collinpowerkariman/ECU/hardware/CAM/CAM.csv

Source: | /home/collyn/KiCAD/CAM_Module/CAM_Module.kicad_sch
Date: | Min 06 Agu 2023 08:49:48
Tool: | Eeschema 7.0.6-7.0.6~ubuntu22.04.1
Generator: | /usr/share/kicad/plugins/bom_csv_grouped_by_value.py
Component Count: | 14
Collated Components:
Item | Qty | Reference(s) | Value | LibPart | Footprint | Datasheet | DNP
1 | 2 | C1, C3 | 100nf | Device:C | Capacitor_SMD:C_0603_1608Metric_Pad1.08x0.95mm_HandSolder | ~
2 | 1 | C2 | 1uf | Device:C | Capacitor_SMD:C_0603_1608Metric_Pad1.08x0.95mm_HandSolder | ~
3 | 1 | C4 | 0.33uf | Device:C | Capacitor_SMD:C_0603_1608Metric_Pad1.08x0.95mm_HandSolder | ~
4 | 2 | D1, D2 | LED | Device:LED | LED_SMD:LED_0603_1608Metric_Pad1.05x0.95mm_HandSolder | ~
5 | 1 | D3 | 5.5v | Device:D_Zener | Diode_SMD:D_0603_1608Metric_Pad1.05x0.95mm_HandSolder | ~
6 | 1 | J1 | Connector | Connector:Conn_01x06_Pin | Connector_PinHeader_2.54mm:PinHeader_1x06_P2.54mm_Vertical | ~
7 | 1 | JP1 | ~ | Jumper:SolderJumper_2_Open | Jumper:SolderJumper-2_P1.3mm_Open_RoundedPad1.0x1.5mm | ~
8 | 1 | JP2 | 5V/12V | Jumper:Jumper_3_Open | Connector_PinHeader_2.54mm:PinHeader_1x03_P2.54mm_Vertical | ~
9 | 1 | R1 | 220 | Device:R | Resistor_SMD:R_0603_1608Metric_Pad0.98x0.95mm_HandSolder | ~
10 | 1 | R2 | 680 | Device:R | Resistor_SMD:R_0603_1608Metric_Pad0.98x0.95mm_HandSolder | ~
11 | 1 | U1 | AS5047P | Sensor_Magnetic:AS5047D | Package_SO:TSSOP-14_4.4x5mm_P0.65mm | https://ams.com/documents/20143/36005/AS5047D_DS000394_2-00.pdf
12 | 1 | U2 | LM78M05_TO252 | Regulator_Linear:LM78M05_TO252 | Package_TO_SOT_SMD:TO-252-2 | https://www.onsemi.com/pub/Collateral/MC78M00-D.PDF
