collinpowerkariman/ECU/hardware/ECU/ECU.kicad_pcb

## KiCad design hardware/ECU/ECU.kicad_pcb (2023-11-11)

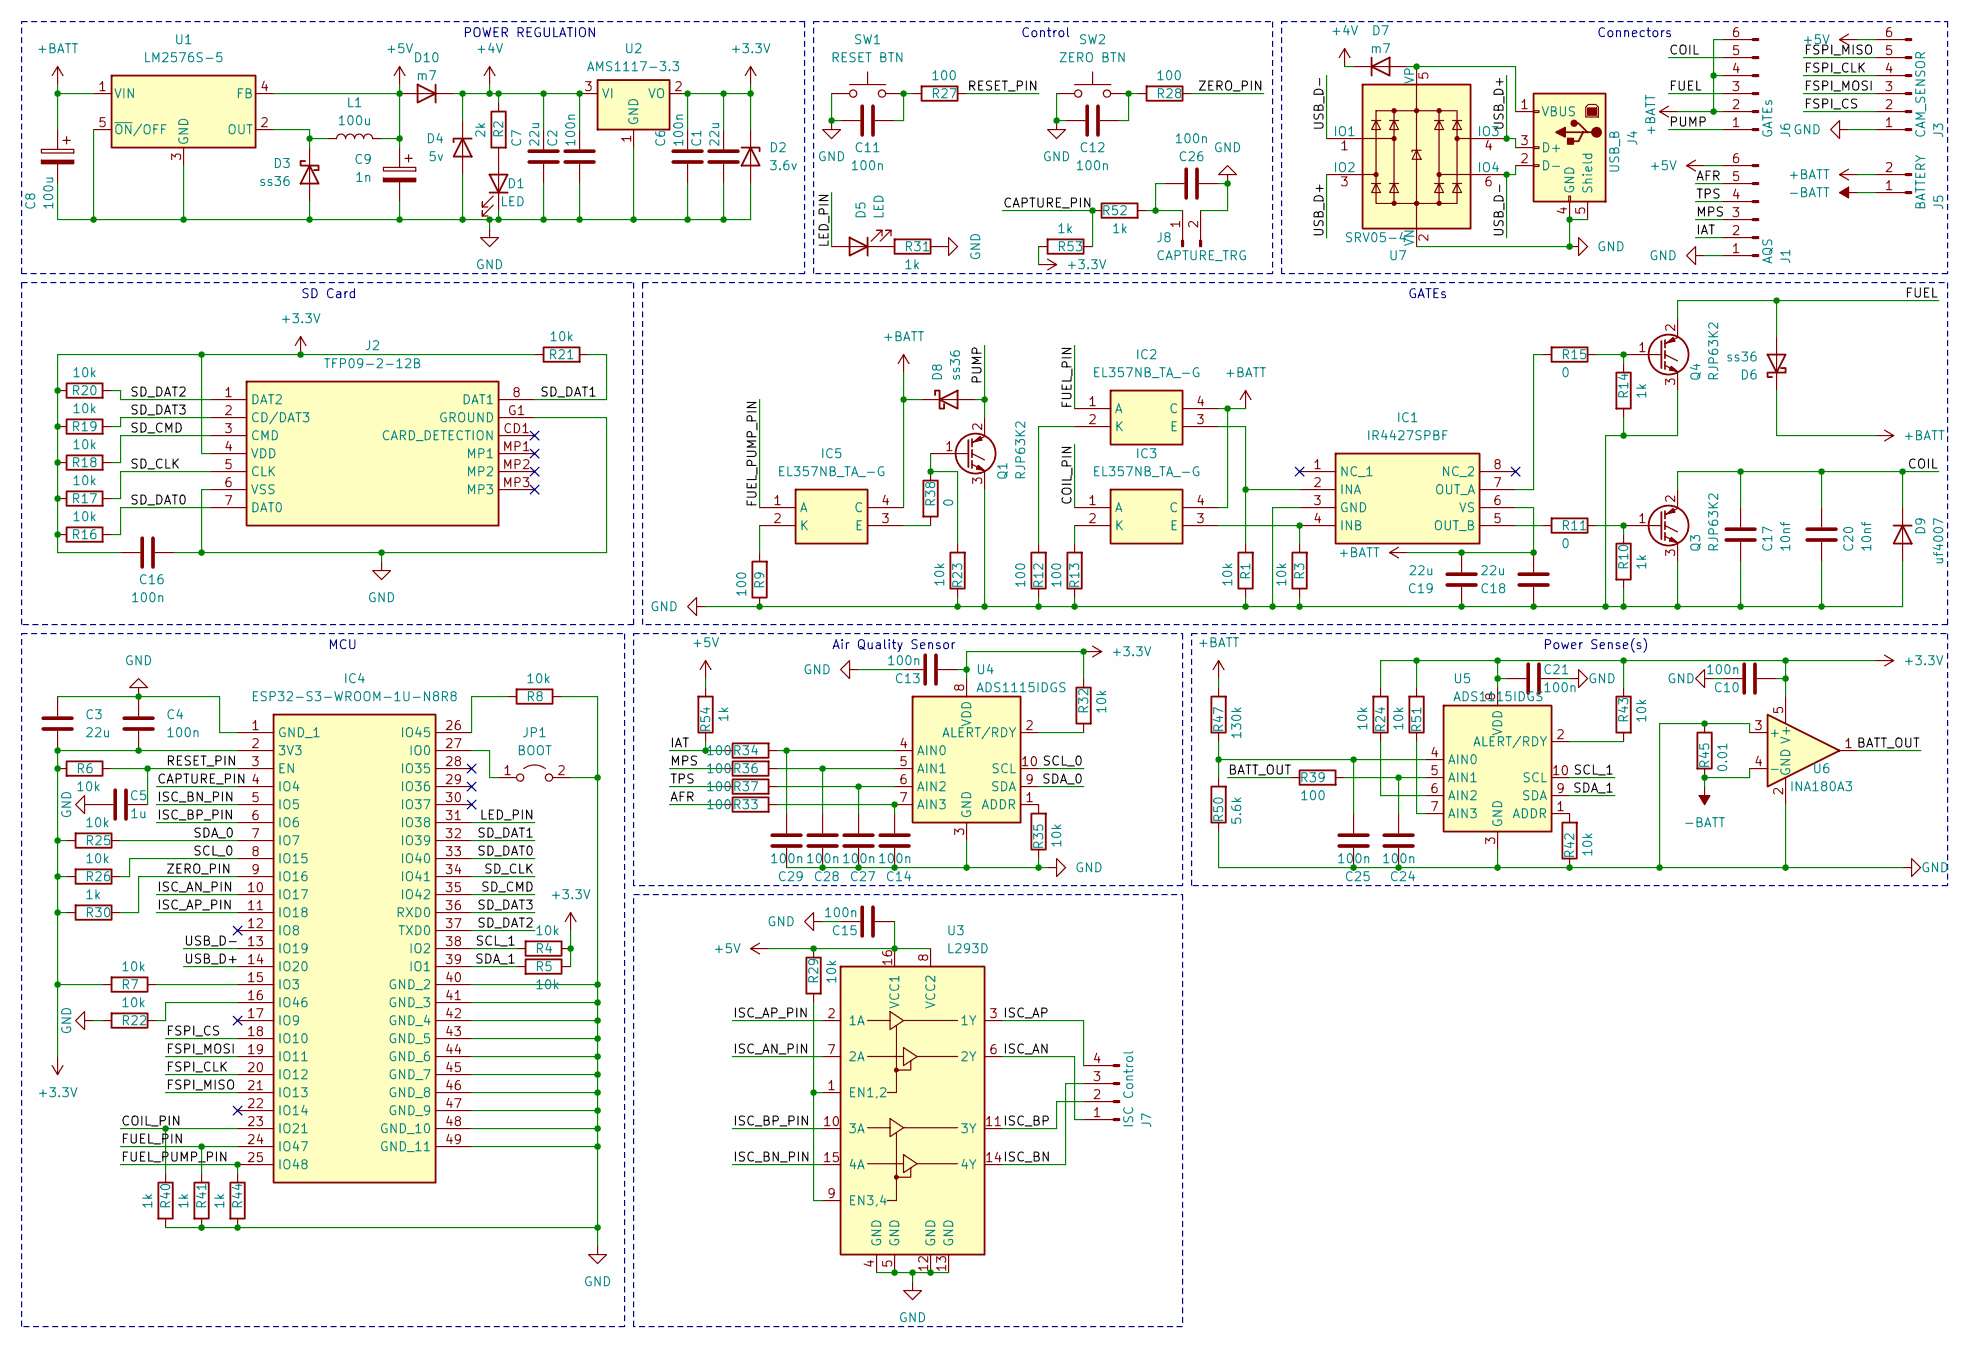
[picture p1: schematic ECU.kicad_sch]

Parts:
C1, C7, C18, C19: 22u; C_0805_2012Metric_Pad1.18x1.45mm_HandSolder
C2, C6: 100n; C_0805_2012Metric_Pad1.18x1.45mm_HandSolder
C3: 22u; C_0603_1608Metric
C4, C10, C11, C12, C13, C14, C15, C21, C24, C25, C26, C27, C28, C29: 100n; C_0603_1608Metric
C5: 1u; C_0603_1608Metric
C8: 100u; CP_Elec_10x10
C9: 1n; CP_Elec_10x10
C16: 100n; C_0603_1608Metric_Pad1.08x0.95mm_HandSolder
C17, C20: 10nf; C_1206_3216Metric_Pad1.33x1.80mm_HandSolder
D1, D5: LED; LED_0603_1608Metric_Pad1.05x0.95mm_HandSolder
D2: 3.6v; D_1206_3216Metric_Pad1.42x1.75mm_HandSolder
D3, D6, D8: ss36; D_SMC
D4: 5v; D_1206_3216Metric_Pad1.42x1.75mm_HandSolder
D7, D10: m7; D_SMA
D9: uf4007; D_SMA
IC1: IR4427SPBF; SOIC127P600X175-8N; Manufacturer_Part_Number IR4427SPBF; Mouser Part Number 942-IR4427SPBF
IC2, IC3, IC5: EL357NB_TA_-G; EL357NG; Manufacturer_Part_Number EL357NB(TA)-G; Mouser Part Number 638-EL357NBTAG
IC4: ESP32-S3-WROOM-1U-N8R8; ESP32S3WROOM1UN4; Manufacturer_Part_Number ESP32-S3-WROOM-1U-N8R8; Mouser Part Number 356-ESP32S3WRM1UN8R8
J1: AQS; JST_XH_B6B-XH-A_1x06_P2.50mm_Vertical
J2: TFP09-2-12B; TFP09212B; Manufacturer_Part_Number TFP09-2-12B
J3: CAM_SENSOR; JST_XH_B6B-XH-A_1x06_P2.50mm_Vertical
J4: USB_B; USB_B_TE_5787834_Vertical
J5: BATTERY; Molex_KK-396_5273-02A_1x02_P3.96mm_Vertical
J6: GATEs; Molex_KK-396_5273-06A_1x06_P3.96mm_Vertical
J7: ISC Control; JST_XH_B4B-XH-A_1x04_P2.50mm_Vertical
J8: CAPTURE_TRG; JST_XH_B2B-XH-A_1x02_P2.50mm_Vertical
JP1: BOOT; PinHeader_1x02_P2.54mm_Vertical
L1: 100u; INDPM102100X400N
Q1, Q3, Q4: RJP63K2; TO-263-2
R1, R3, R4, R5, R6, R7, R8, R22, R23, R24, R25, R26, R29, R32, R35, R42, R43, R51: 10k; R_0603_1608Metric_Pad0.98x0.95mm_HandSolder
R2: 2k; R_0603_1608Metric_Pad0.98x0.95mm_HandSolder
R9, R12, R13, R27, R28, R33, R34, R36, R37, R39: 100; R_0603_1608Metric_Pad0.98x0.95mm_HandSolder
R10, R14, R30, R31, R40, R41, R44, R52, R53, R54: 1k; R_0603_1608Metric_Pad0.98x0.95mm_HandSolder
R11, R15, R38: 0; R_0603_1608Metric_Pad0.98x0.95mm_HandSolder
R16, R17, R18, R19, R20, R21: 10k; R_0603_1608Metric
R45: 0.01; RESC10052X106N
R47: 130k; R_0603_1608Metric_Pad0.98x0.95mm_HandSolder
R50: 5.6k; R_0603_1608Metric_Pad0.98x0.95mm_HandSolder
SW1: RESET BTN; SW_SPST_PTS810
SW2: ZERO BTN; SW_SPST_PTS810
U1: LM2576S-5; TO-263-5_TabPin3
U2: AMS1117-3.3; SOT-223-3_TabPin2
U3: L293D; DIP-16_W7.62mm_SMDSocket_SmallPads
U4, U5: ADS1115IDGS; TSSOP-10_3x3mm_P0.5mm
U6: INA180A3; SOT-23-5
U7: SRV05-4; SOT-23-6

Connections:
+3.3V: C1.1, C3.2, C4.2, C6.1, C10.2, C13.2, C16.1, C21.2, D2.1 (K), IC4.2 (3V3), J2.4 (VDD), R4.1, R5.1, R6.2, R7.2, R16.1, R17.1, R18.1, R19.1, R20.1, R21.1, R24.2, R25.2, R26.2, R30.2, R32.1, R43.1, R51.2, R53.2, U2.2 (VO), U4.8 (VDD), U5.8 (VDD), U6.5 (V+)
+4V: C2.1, C7.1, D4.1 (K), D7.1 (K), D10.1 (K), R2.1, U2.3 (VI)
+5V: C9.1, C15.2, D10.2 (A), J1.6, J3.6, L1.2, R29.1, R54.2, U1.4 (FB), U3.8 (VCC2), U3.16 (VCC1)
+BATT: C8.1, C18.1, C19.1, D6.1 (K), D8.1 (K), IC1.6 (VS), IC2.4 (C), IC3.4 (C), IC5.4 (C), J5.2, J6.2, J6.4, J6.6, R47.2, U1.1 (VIN)
-BATT: J5.1, R45.2, U6.4 (-)
/AFR: J1.5, R33.1
/BATT_OUT: R39.1, U6.1
/CAPTURE_PIN: IC4.4 (IO4), R52.1, R53.1
/COIL: C17.1, C20.1, D9.1 (K), J6.5, Q3.2 (C)
/COIL_PIN: IC3.1 (A), IC4.23 (IO21), R40.1
/FSPI_CLK: IC4.20 (IO12), J3.4
/FSPI_CS: IC4.18 (IO10), J3.2
/FSPI_MISO: IC4.21 (IO13), J3.5
/FSPI_MOSI: IC4.19 (IO11), J3.3
/FUEL: D6.2 (A), J6.3, Q4.2 (C)
/FUEL_PIN: IC2.1 (A), IC4.24 (IO47), R41.1
/FUEL_PUMP_PIN: IC4.25 (IO48), IC5.1 (A), R44.1
/IAT: J1.2, R34.1, R54.1
/ISC_AN: J7.1, U3.6 (2Y)
/ISC_AN_PIN: IC4.10 (IO17), U3.7 (2A)
/ISC_AP: J7.4, U3.3 (1Y)
/ISC_AP_PIN: IC4.11 (IO18), U3.2 (1A)
/ISC_BN: J7.3, U3.14 (4Y)
/ISC_BN_PIN: IC4.5 (IO5), U3.15 (4A)
/ISC_BP: J7.2, U3.11 (3Y)
/ISC_BP_PIN: IC4.6 (IO6), U3.10 (3A)
/LED_PIN: D5.2 (A), IC4.31 (IO38)
/MPS: J1.3, R36.1
/PUMP: D8.2 (A), J6.1, Q1.2 (C)
/RESET_PIN: C5.2, IC4.3 (EN), R6.1, R27.1
/SCL_0: IC4.8 (IO15), R26.1, U4.10 (SCL)
/SCL_1: IC4.38 (IO2), R4.2, U5.10 (SCL)
/SDA_0: IC4.7 (IO7), R25.1, U4.9 (SDA)
/SDA_1: IC4.39 (IO1), R5.2, U5.9 (SDA)
/SD_CLK: IC4.34 (IO41), J2.5 (CLK), R17.2
/SD_CMD: IC4.35 (IO42), J2.3 (CMD), R18.2
/SD_DAT0: IC4.33 (IO40), J2.7 (DAT0), R16.2
/SD_DAT1: IC4.32 (IO39), J2.8 (DAT1), R21.2
/SD_DAT2: IC4.37 (TXD0), J2.1 (DAT2), R20.2
/SD_DAT3: IC4.36 (RXD0), J2.2 (CD/DAT3), R19.2
/TPS: J1.4, R37.1
/USB_D+: IC4.14 (IO20), J4.3 (D+), U7.3 (IO2), U7.4 (IO3)
/USB_D-: IC4.13 (IO19), J4.2 (D-), U7.1 (IO1), U7.6 (IO4)
/ZERO_PIN: IC4.9 (IO16), R28.1, R30.1
GND: C1.2, C2.2, C3.1, C4.1, C5.1, C6.2, C7.2, C8.2, C9.2, C10.1, C11.1, C12.1, C13.1, C14.1, C15.1, C16.2, C17.2, C18.2, C19.2, C20.2, C21.1, C24.1, C25.1, C26.1, C27.1, C28.1, C29.1, D1.1 (K), D2.2 (A), D3.2 (A), D4.2 (A), D9.2 (A), IC1.3 (GND), IC4.1 (GND_1), IC4.40 (GND_2), IC4.41 (GND_3), IC4.42 (GND_4), IC4.43 (GND_5), IC4.44 (GND_6), IC4.45 (GND_7), IC4.46 (GND_8), IC4.47 (GND_9), IC4.48 (GND_10), IC4.49 (GND_11), J1.1, J2.6 (VSS), J2.G1 (GROUND), J3.1, J4.4 (GND), J4.5 (Shield), J8.2, JP1.2 (B), Q1.3 (E), Q3.3 (E), Q4.3 (E), R1.1, R3.1, R8.1, R9.1, R10.2, R12.1, R13.1, R14.2, R22.2, R23.1, R31.1, R35.1, R40.2, R41.2, R42.1, R44.2, R45.1, R50.1, SW1.1, SW2.1, U1.3 (GND), U1.5 (~ON/OFF), U2.1 (GND), U3.4 (GND), U3.5 (GND), U3.12 (GND), U3.13 (GND), U4.3 (GND), U5.3 (GND), U6.2 (GND), U6.3 (+), U7.2 (VN)
unnamed: C11.2, R27.2, SW1.2
unnamed: C12.2, R28.2, SW2.2
unnamed: D1.2 (A), R2.2
unnamed: D3.1 (K), L1.1, U1.2 (OUT)
unnamed: D5.1 (K), R31.2
unnamed: D7.2 (A), J4.1 (VBUS), U7.5 (VP)
unnamed: IC1.2 (INA), IC2.3 (E), R1.2
unnamed: IC1.4 (INB), IC3.3 (E), R3.2
unnamed: IC1.7 (OUT_A), R15.2
unnamed: IC1.5 (OUT_B), R11.2
unnamed: IC2.2 (K), R12.2
unnamed: IC3.2 (K), R13.2
unnamed: IC4.27 (IO0), JP1.1 (A)
unnamed: IC4.15 (IO3), R7.1
unnamed: IC4.26 (IO45), R8.2
unnamed: IC4.16 (IO46), R22.1
unnamed: IC5.3 (E), R38.2
unnamed: IC5.2 (K), R9.2
unnamed: C26.2, J8.1, R52.2
unnamed: Q1.1 (G), R23.2, R38.1
unnamed: Q3.1 (G), R10.1, R11.1
unnamed: Q4.1 (G), R14.1, R15.1
unnamed: R29.2, U3.1 (EN1,2), U3.9 (EN3,4)
unnamed: R35.2, U4.1 (ADDR)
unnamed: C29.2, R34.2, U4.4 (AIN0)
unnamed: C28.2, R36.2, U4.5 (AIN1)
unnamed: C27.2, R37.2, U4.6 (AIN2)
unnamed: C14.2, R33.2, U4.7 (AIN3)
unnamed: R32.2, U4.2 (ALERT/RDY)
unnamed: R42.2, U5.1 (ADDR)
unnamed: C25.2, R47.1, R50.2, U5.4 (AIN0)
unnamed: C24.2, R39.2, U5.5 (AIN1)
unnamed: R24.1, U5.6 (AIN2)
unnamed: R51.1, U5.7 (AIN3)
unnamed: R43.2, U5.2 (ALERT/RDY)

Notes on the sheet:
POWER REGULATION
Connectors
Power Sense(s)
MCU
GATEs
Control
SD Card
Air Quality Sensor

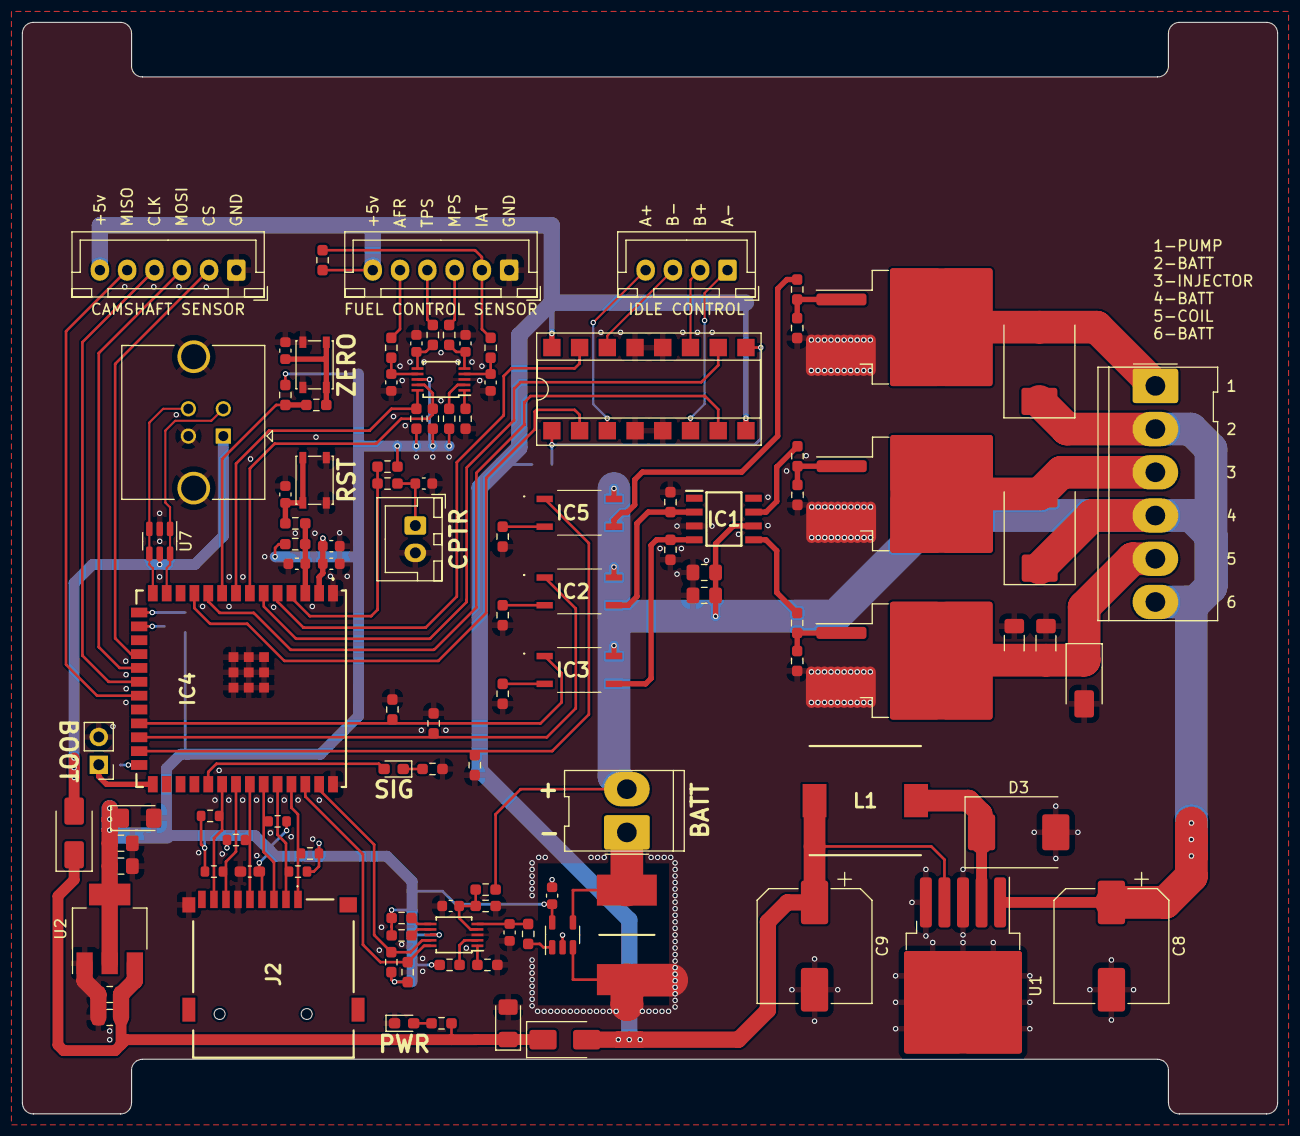
[picture p2: board ECU.kicad_pcb from above]

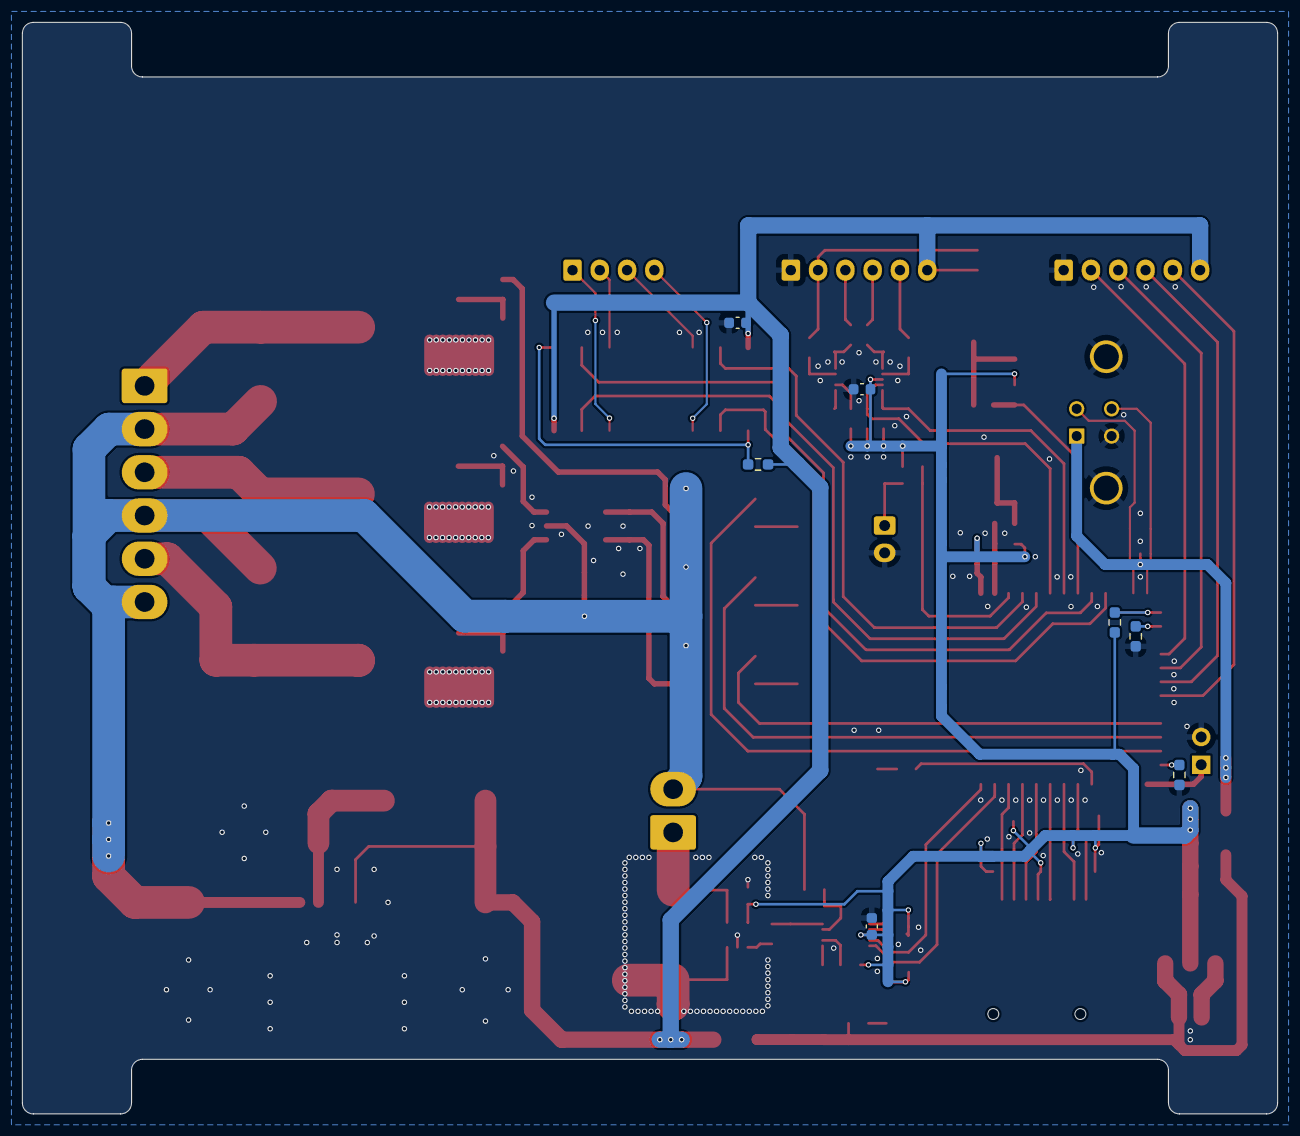
[picture p3: board ECU.kicad_pcb from below]

Board: 2 copper layers, 115.0 x 100.0 mm, 115 parts (7 on the bottom side), 80 nets.
