collinpowerkariman/ECU/hardware/CAM/CAM.kicad_pcb

## KiCad design hardware/CAM/CAM.kicad_pcb (2023-10-10)

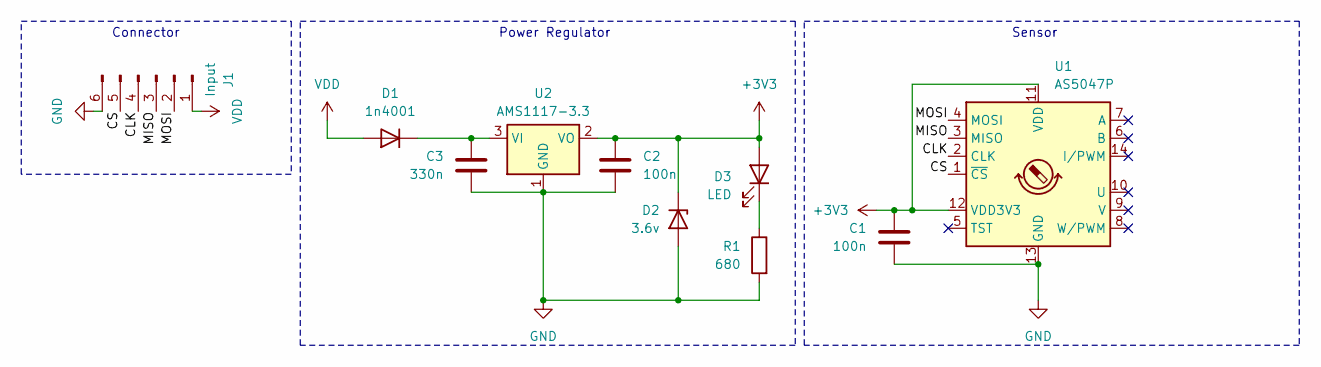
[picture p4: schematic CAM.kicad_sch]

Parts:
C1, C2: 100n; C_0603_1608Metric
C3: 330n; C_0603_1608Metric
D1: 1n4001; D_SMA
D2: 3.6v; D_MiniMELF
D3: LED; D_0603_1608Metric
J1: Input; 6P_Board_To_Wire_Pad
R1: 680; R_0603_1608Metric
U1: AS5047P; TSSOP-14_4.4x5mm_P0.65mm
U2: AMS1117-3.3; SOT-223-3_TabPin2

Connections:
+3V3: C1.1, C2.1, D2.1 (K), D3.2 (A), U1.11 (VDD), U1.12 (VDD3V3), U2.2 (VO)
/CLK: J1.4, U1.2 (CLK)
/CS: J1.5, U1.1 (~CS)
/MISO: J1.3, U1.3 (MISO)
/MOSI: J1.2, U1.4 (MOSI)
GND: C1.2, C2.2, C3.2, D2.2 (A), J1.6, R1.2, U1.13 (GND), U2.1 (GND)
unnamed: C3.1, D1.1 (K), U2.3 (VI)
unnamed: D3.1 (K), R1.1
VDD: D1.2 (A), J1.1

Notes on the sheet:
Power Regulator
Sensor
Connector

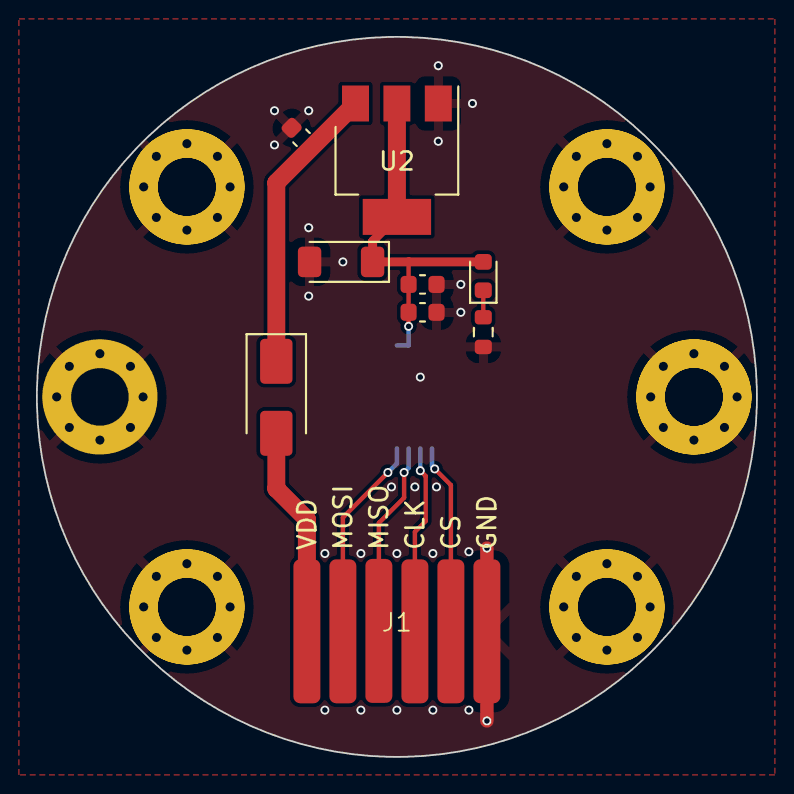
[picture p5: board CAM.kicad_pcb from above]

Board: 2 copper layers, 40.0 x 40.0 mm, 10 parts (1 on the bottom side), 9 nets.
