collinpowerkariman/ECU/(commit log)

2023-10-10 simplify camshaft sensor schematic and add extra mounting hole
    [CAM-B_Cu.gbr, CAM-B_Mask.gbr, CAM-B_Paste.gbr, CAM-B_Silkscreen.gbr, CAM-Edge_Cuts.gbr, CAM-F_Cu.gbr, CAM-F_Mask.gbr, CAM-F_Paste.gbr]
2023-11-06 ECU hardware v0.2 candidate
    [ECU-B_Cu.gbr, ECU-B_Mask.gbr, ECU-B_Paste.gbr, ECU-B_Silkscreen.gbr, ECU-Edge_Cuts.gbr, ECU-F_Cu.gbr, ECU-F_Mask.gbr, ECU-F_Paste.gbr]
2023-11-08 add idle control circuit
    [ECU-B_Cu.gbr, ECU-B_Mask.gbr, ECU-B_Paste.gbr, ECU-B_Silkscreen.gbr, ECU-Edge_Cuts.gbr, ECU-F_Cu.gbr, ECU-F_Mask.gbr, ECU-F_Paste.gbr]
2023-11-11 fix gerber file containing deleted layers
    [ECU-B_Cu.gbr, ECU-B_Mask.gbr, ECU-B_Paste.gbr, ECU-B_Silkscreen.gbr, ECU-Edge_Cuts.gbr, ECU-F_Cu.gbr, ECU-F_Mask.gbr, ECU-F_Paste.gbr]
